hnchou0502/ackermann-slam-robot/firmware/Core/Inc/main.h

#define IMU_CS_Pin GPIO_PIN_12
#define IMU_CS_GPIO_Port GPIOB
#define MOTOR_A_DIR_PORT      GPIOC
#define MOTOR_A_DIR_PIN       GPIO_PIN_6
#define MOTOR_B_DIR_PORT      GPIOC
#define MOTOR_B_DIR_PIN       GPIO_PIN_8
#define MOTOR_A_PWM_TIM       &htim3
#define MOTOR_A_PWM_CHANNEL   TIM_CHANNEL_2
#define MOTOR_B_PWM_TIM       &htim3
#define MOTOR_B_PWM_CHANNEL   TIM_CHANNEL_4
#define SERVO_GPIO_PORT       GPIOC
#define SERVO_GPIO_PIN        GPIO_PIN_0
#define LED_GPIO_Port         GPIOC
#define LED_Pin               GPIO_PIN_13
